yan/alti/hardware/docs/stm32l1_pins.xlsx

Sheet: Pins
UFQFPN48 | Name | Type | Structure | Function | AltFunc | AddtlFunc |  | Alti Assignment | Target
1 | VLCD(3) | S | VLCD | - | - |  |  | ?????????
2 | PC13-WKUP2 | I/O | FT | PC13 | - | RTC_TAMP1/RTC_TS/RTC_OUT/WKUP2
3 | PC14-OSC32_IN(4) | I/O | TC | PC14 | - | OSC32_IN |  | HSE | 16MHz xtal
4 | PC15-OSC32_OUT(4) | I/O | TC | PC15 | - | OSC32_OUT |  | HSE | 16MHz xtal
5 | PH0-OSC_IN(5) | I/O | TC | PH0 | - | OSC_IN |  | LSE | 32k xtal
6 | PH1-OSC_OUT | I/O | TC | PH1 | - | OSC_OUT |  | LSE | 32k xtal
7 | NRST | I/O | RST | NRST | - | - |  | RESET | Switch | CDC
8 | VSSA | S | - | VSSA | - | - |  | GND
9 | VDDA | S | - | VDDA | - | - |  | +3V
10 | PA0-WKUP1 | I/O | FT | PA0 | USART2_CTS/TIM2_CH1_ETR | WKUP1/ADC_IN0/COMP1_INP |  |  |  | AT45DB321E_RESET
11 | PA1 | I/O | FT | PA1 | USART2_RTS/TIM2_CH2/LCD_SEG0 | ADC_IN1/COMP1_INP |  |  |  | AT45DB321E_enable
12 | PA2 | I/O | FT | PA2 | USART2_TX/TIM2_CH3/TIM9_CH1/LCD_SEG1 | ADC_IN2/COMP1_INP |  |  | nrf8001_RSET
13 | PA3 | I/O | TC | PA3 | USART2_RX/TIM2_CH4/TIM9_CH2/LCD_SEG2 | ADC_IN3/COMP1_INP |  |  | nrf8001_RDYN
14 | PA4 | I/O | TC | PA4 | SPI1_NSS/USART2_CK | ADC_IN4/DAC_OUT1/COMP1_INP |  |  | nrf8001_REQN
15 | PA5 | I/O | TC | PA5 | SPI1_SCK/TIM2_CH1_ETR | ADC_IN5/DAC_OUT2/COMP1_INP |  | SPI1_SCK | nrf8001_SCK | AT45DB321E_SCK
16 | PA6 | I/O | FT | PA6 | SPI1_MISO/TIM3_CH1/LCD_SEG3/TIM10_CH1 | ADC_IN6/COMP1_INP |  | SPI1_MISO | nrf8001_MISO | AT45DB321E_MISO
17 | PA7 | I/O | FT | PA7 | SPI1_MOSI//TIM3_CH2/LCD_SEG4/TIM11_CH1 | ADC_IN7/COMP1_INP |  | SPI1_MOSI | nrf8001_MOSI | AT45DB321E_MOSI
18 | PB0 | I/O | TC | PB0 | TIM3_CH3/LCD_SEG5 | ADC_IN8/COMP1_INP/VREF_OUT
19 | PB1 | I/O | FT | PB1 | TIM3_CH4/LCD_SEG6 | ADC_IN9/COMP1_INP/VREF_OUT
20 | PB2 | I/O | FT | PB2/BOOT1 | BOOT1 | -
21 | PB10 | I/O | FT | PB10 | I2C2_SCL/USART3_TX/TIM2_CH3/LCD_SEG10 | - |  | NRF8001_Enable | nrf8001_enable
22 | PB11 | I/O | FT | PB11 | I2C2_SDA/USART3_RX/TIM2_CH4/LCD_SEG11 | - |  | ms5611_enable
23 | VSS_1 | S | - | VSS_1 | - | - |  | GND
24 | VDD_1 | S | - | VDD_1 | - | - |  | +3V
25 | PB12 | I/O | FT | PB12 | SPI2_NSS/I2C2_SMBA/USART3_CK/LCD_SEG12/TIM10_CH1 | ADC_IN18/COMP1_INP |  | ms5611_enable | ms5611_enable
26 | PB13 | I/O | FT | PB13 | SPI2_SCK/USART3_CTS/LCD_SEG13/TIM9_CH1 | ADC_IN19/COMP1_INP |  | SPI2_SCK | BMX055 SCK | MS5611_SCK
27 | PB14 | I/O | FT | PB14 | SPI2_MISO/USART3_RTS/LCD_SEG14//TIM9_CH2 | ADC_IN20/COMP1_INP |  | SPI2_MISO | BMX055 MISO | MS5611_MISO
28 | PB15 | I/O | FT | PB15 | SPI2_MOSI/LCD_SEG15/TIM11_CH1 | ADC_IN21/COMP1_INP/RTC_REFIN |  | SPI2_MOSI | BMX055 MOSI | MS5611_MOSI
29 | PA8 | I/O | FT | PA8 | USART1_CK/MCO/LCD_COM0 | - |  |  | BMX055 M EN
30 | PA9 | I/O | FT | PA9 | USART1_TX/LCD_COM1 | - |  |  | BMX055 A EN
31 | PA10 | I/O | FT | PA10 | USART1_RX/LCD_COM2 | - |  |  | BMX055 G EN
32 | PA11 | I/O | FT | PA11 | USART1_CTS | USB_DM |  | USB_DM | USB_HEADER
33 | PA12 | I/O | FT | PA12 | USART1_RTS/SPI1_MOSI | USB_DP |  | USB_DP | USB_HEADER
34 | PA13 | I/O | FT | JTMSSWDIO | JTMS-SWDIO | - |  | SWD |  | CDC
35 | VSS_2 | S | - | VSS_2 | - | - |  | GND
36 | VDD_2 | S | - | VDD_2 | - | - |  | +3V
37 | PA14 | I/O | FT | JTCK | -SWCLK | JTCK-SWCLK |  | SWCLK |  | CDC
38 | PA15 | I/O | FT | JTDI | TIM2_CH1_ETR/PA15/SPI1_NSS/LCD_SEG17 | - |  |  |  | CDC
39 | PB3 | I/O | FT | JTDO | TIM2_CH2/PB3/SPI1_SCK/LCD_SEG7/JTDO | COMP2_INM |  |  |  | CDC
40 | PB4 | I/O | FT | NJTRST | TIM3_CH1/PB4/SPI1_MISO/LCD_SEG8/NJTRST | COMP2_INP |  | STATUS LED
41 | PB5 | I/O | FT | PB5 | I2C1_SMBA/TIM3_CH2/SPI1_MOSI/LCD_SEG9 | COMP2_INP
42 | PB6 | I/O | FT | PB6 | I2C1_SCL/TIM4_CH1/USART1_TX
43 | PB7 | I/O | FT | PB7 | I2C1_SDA/TIM4_CH2/USART1_RX | PVD_IN
44 | BOOT0 | I | B | BOOT0 | - | - |  | BOOT0 (tie to gnd or vcc)
45 | PB8 | I/O | FT | PB8 | TIM4_CH3/I2C1_SCL/LCD_SEG16/TIM10_CH1 | - |  | WARN LED select
46 | PB9 | I/O | FT | PB9 | TIM4_CH4/I2C1_SDA/LCD_COM3/TIM11_CH1 | - |  | WARN LED enable
47 | VSS_3 | S | - | VSS_3 | - | - |  | GND
48 | VDD_3 | S | - | VDD_3 | - | - |  | +3V
- | PE2 | I/O | FT | PE2 | TRACECLK/LCD_SEG38/TIM3_ETR | -
- | PE3 | I/O | FT | PE3 | TRACED0/LCD_SEG39/TIM3_CH1 | -
- | PE4 | I/O | FT | PE4 | TRACED1/TIM3_CH2 | -
- | PE5 | I/O | FT | PE5 | TRACED2/TIM9_CH1 | -
- | PE6-WKUP3 | I/O | FT | PE6 | TRACED3/TIM9_CH2 | WKUP3
- | VSS_5 | S | - | VSS_5 | - | -
- | VDD_5 | S | - | VDD_5 | - | -
- | PC0 | I/O | FT | PC0 | LCD_SEG18 | ADC_IN10//COMP1_INP
- | PC1 | I/O | FT | PC1 | LCD_SEG19 | ADC_IN11/COMP1_INP
- | PC2 | I/O | FT | PC2 | LCD_SEG20 | ADC_IN12/COMP1_INP
- | PC3 | I/O | TC | PC3 | LCD_SEG21 | ADC_IN13/COMP1_INP
- | VREF- | S | - | VREF- | - | -
- | VREF+ | S | - | VREF+ | - | -
- | VSS_4 | S | - | VSS_4 | - | -
- | VDD_4 | S | - | VDD_4 | - | -
- | PC4 | I/O | FT | PC4 | LCD_SEG22 | ADC_IN14/COMP1_INP
- | PC5 | I/O | FT | PC5 | LCD_SEG23 | ADC_IN15/COMP1_INP
- | PE7 | I/O | TC | PE7 | - | ADC_IN22/COMP1_INP
- | PE8 | I/O | TC | PE8 | - | ADC_IN23/COMP1_INP
- | PE9 | I/O | TC | PE9 | TIM2_CH1_ETR | ADC_IN24/COMP1_INP
- | PE10 | I/O | TC | PE10 | TIM2_CH2 | ADC_IN25/COMP1_INP
- | PE11 | I/O | FT | PE11 | TIM2_CH3 | -
- | PE12 | I/O | FT | PE12 | TIM2_CH4/SPI1_NSS | -
- | PE13 | I/O | FT | PE13 | SPI1_SCK | -
- | PE14 | I/O | FT | PE14 | SPI1_MISO | -
- | PE15 | I/O | FT | PE15 | SPI1_MOSI | -
- | PD8 | I/O | FT | PD8 | USART3_TX/LCD_SEG28 | -
- | PD9 | I/O | FT | PD9 | USART3_RX/LCD_SEG29 | - | -
- | PD10 | I/O | FT | PD10 | USART3_CK/LCD_SEG30 | -
- | PD11 | I/O | FT | PD11 | USART3_CTS/LCD_SEG31 | -
- | PD12 | I/O | FT | PD12 | TIM4_CH1/USART3_RTS/LCD_SEG32 | -
- | PD13 | I/O | FT | PD13 | TIM4_CH2/LCD_SEG33 | -
- | PD14 | I/O | FT | PD14 | TIM4_CH3/LCD_SEG34 | -
- | PD15 | I/O | FT | PD15 | TIM4_CH4/LCD_SEG35 | -
- | PC6 | I/O | FT | PC6 | TIM3_CH1/LCD_SEG24 | -
- | PC7 | I/O | FT | PC7 | TIM3_CH2/LCD_SEG25 | -
- | PC8 | I/O | FT | PC8 | TIM3_CH3/LCD_SEG26 | -
- | PC9 | I/O | FT | PC9 | TIM3_CH4/LCD_SEG27 | -
- | PH2 | I/O | FT | PH2 | - | -
- | PC10 | I/O | FT | PC10 | USART3_TX/LCD_SEG28/LCD_SEG40/LCD_COM4 | -
- | PC11 | I/O | FT | PC11 | USART3_RX/LCD_SEG29/LCD_SEG41/LCD_COM5 | -
- | PC12 | I/O | FT | PC12 | USART3_CK/LCD_SEG30/LCD_SEG42/LCD_COM6 | -
- | PD0 | I/O | FT | PD0 | SPI2_NSS/TIM9_CH1 | -
- | PD1 | I/O | FT | PD1 | SPI2_SCK | -
- | PD2 | I/O | FT | PD2 | TIM3_ETR/LCD_SEG31/LCD_SEG43/LCD_COM7 | -
- | PD3 | I/O | FT | PD3 | USART2_CTS/SPI2_MISO | -
- | PD4 | I/O | FT | PD4 | USART2_RTS/SPI2_MOSI | -
- | PD5 | I/O | FT | PD5 | USART2_TX | -
- | PD6 | I/O | FT | PD6 | USART2_RX | -
- | PD7 | I/O | FT | PD7 | USART2_CK/TIM9_CH2 | -
- | PE0 | I/O | FT | PE0 | TIM4_ETR/LCD_SEG36/TIM10_CH1 | -
- | PE1 | I/O | FT | PE1 | LCD_SEG37/TIM11_CH1 | -
 |  |  |  |  |  |  |  |  | BMX055 A Interrupt
 |  |  |  |  |  |  |  |  | Piezo Enable
 |  |  |  |  |  |  |  |  | Piezo Out

Sheet: BOM
Mfgr Part # | Description | Price
