yan/alti/hardware/pcb/aero.kicad_pcb

## KiCad design hardware/pcb/aero.kicad_pcb (2015-10-28)

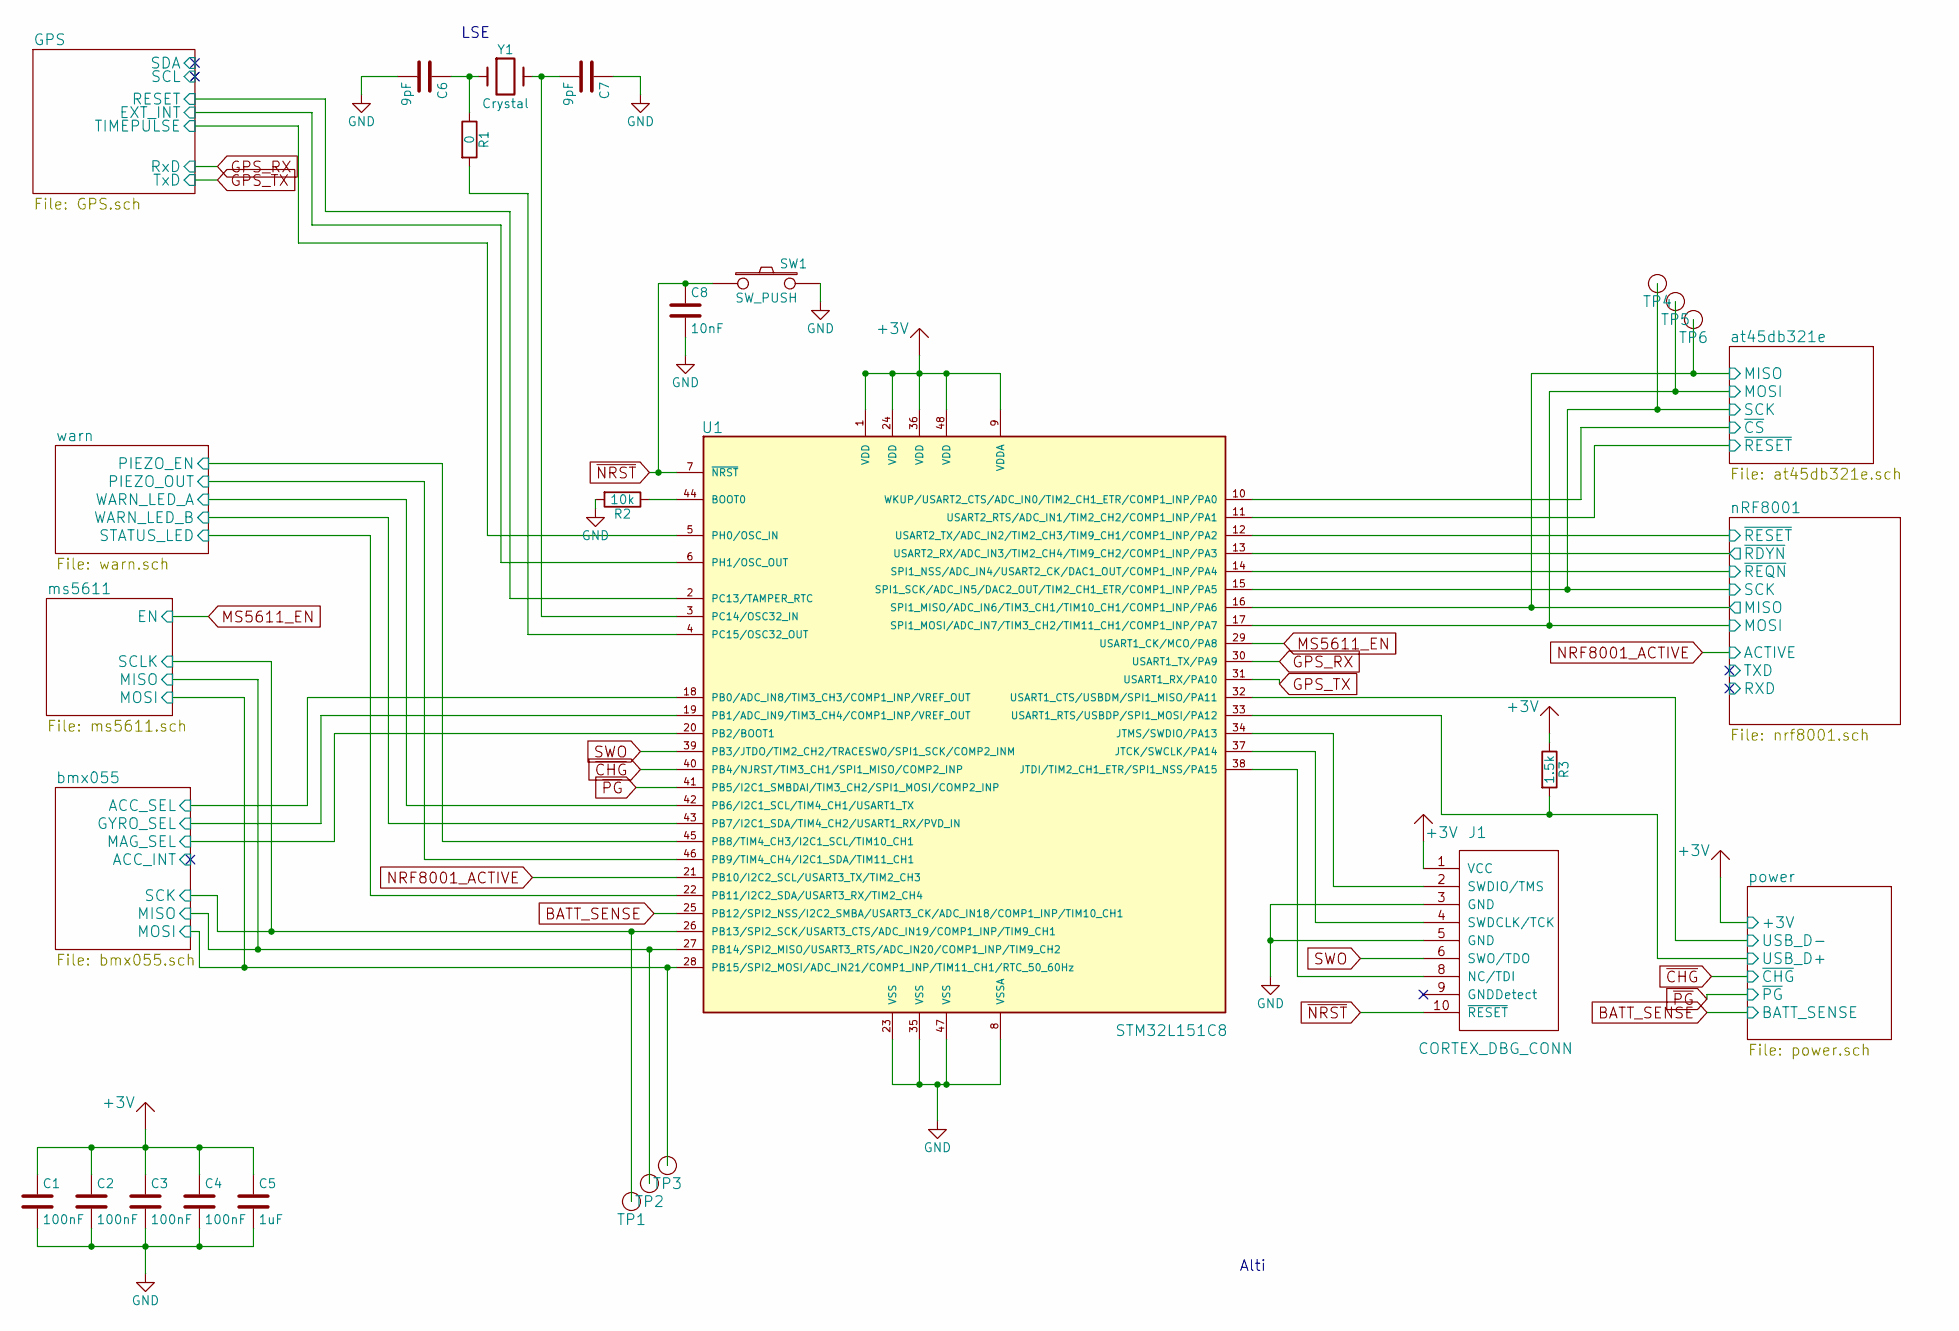
[picture p1: schematic aero.sch]

Parts:
C1, C2, C3, C4: 100nF; C_0402
C5: 1uF; C_0402
C6, C7: 9pF; C_0402
C8: 10nF; C_0402
J1: CORTEX_DBG_CONN; TC2050-IDC-NL
R1: 0; R_0402
R2: 10k; R_0402
R3: 1.5k; R_0402
SW1: SW_PUSH; B3U-1000P
TP1, TP2, TP3, TP4, TP5, TP6: Test_Point; TP_0603
U1: STM32L151C8; UFQFPN48
Y1: Crystal; Crystal_32768_FC-135R

Connections:
+3V: C1.1, C2.1, C3.1, C4.1, C5.1, J1.1 (VCC), R3.1, U1.1 (VDD), U1.9 (VDDA), U1.24 (VDD), U1.36 (VDD), U1.48 (VDD); also elsewhere on the board
/GPS/EXT_INT: U1.6 (PH1/OSC_OUT); also elsewhere on the board
/GPS/RESET: U1.2 (PC13/TAMPER_RTC); also elsewhere on the board
/GPS/TIMEPULSE: U1.5 (PH0/OSC_IN); also elsewhere on the board
/at45db321e/MISO: TP6.1, U1.16 (SPI1_MISO/ADC_IN6/TIM3_CH1/TIM10_CH1/CO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); also elsewhere on the board
/at45db321e/MOSI: TP5.1, U1.17 (SPI1_MOSI/ADC_IN7/TIM3_CH2/TIM11_CH1/CO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); also elsewhere on the board
/at45db321e/SCK: TP4.1, U1.15 (SPI1_SCK/ADC_IN5/DAC2_OUT/TIM2_CH1_ETR/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); also elsewhere on the board
/at45db321e/~CS: U1.10 (WKUP/USART2_CTS/ADC_IN0/TIM2_CH1_ETR/CO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); also elsewhere on the board
/at45db321e/~RESET: U1.11 (USART2_RTS/ADC_IN1/TIM2_CH2/COMP1_INP/P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); also elsewhere on the board
/bmx055/ACC_SEL: U1.18 (PB0/ADC_IN8/TIM3_CH3/COMP1_INP/VREF_OUT); also elsewhere on the board
/bmx055/GYRO_SEL: U1.19 (PB1/ADC_IN9/TIM3_CH4/COMP1_INP/VREF_OUT); also elsewhere on the board
/bmx055/MAG_SEL: U1.20 (PB2/BOOT1); also elsewhere on the board
/bmx055/MISO: TP2.1, U1.27 (PB14/SPI2_MISO/USART3_RTS/ADC_IN20/COMP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); also elsewhere on the board
/bmx055/MOSI: TP3.1, U1.28 (PB15/SPI2_MOSI/ADC_IN21/COMP1_INP/TIM11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); also elsewhere on the board
/bmx055/SCK: TP1.1, U1.26 (PB13/SPI2_SCK/USART3_CTS/ADC_IN19/COMP1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); also elsewhere on the board
/nRF8001/~RDYN: U1.13 (USART2_RX/ADC_IN3/TIM2_CH4/TIM9_CH2/COM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); also elsewhere on the board
/nRF8001/~REQN: U1.14 (SPI1_NSS/ADC_IN4/USART2_CK/DAC1_OUT/COM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); also elsewhere on the board
/nRF8001/~RESET: U1.12 (USART2_TX/ADC_IN2/TIM2_CH3/TIM9_CH1/COM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); also elsewhere on the board
/power/USB_D+: R3.2, U1.33 (USART1_RTS/USBDP/SPI1_MOSI/PA12); also elsewhere on the board
/power/USB_D-: U1.32 (USART1_CTS/USBDM/SPI1_MISO/PA11); also elsewhere on the board
/warn/PIEZO_EN: U1.45 (PB8/TIM4_CH3/I2C1_SCL/TIM10_CH1); also elsewhere on the board
/warn/PIEZO_OUT: U1.46 (PB9/TIM4_CH4/I2C1_SDA/TIM11_CH1); also elsewhere on the board
/warn/STATUS_LED: U1.22 (PB11/I2C2_SDA/USART3_RX/TIM2_CH4); also elsewhere on the board
/warn/WARN_LED_A: U1.42 (PB6/I2C1_SCL/TIM4_CH1/USART1_TX); also elsewhere on the board
/warn/WARN_LED_B: U1.43 (PB7/I2C1_SDA/TIM4_CH2/USART1_RX/PVD_IN); also elsewhere on the board
BATT_SENSE: U1.25 (PB12/SPI2_NSS/I2C2_SMBA/USART3_CK/ADC_I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); also elsewhere on the board
GND: C1.2, C2.2, C3.2, C4.2, C5.2, C6.2, C7.1, C8.2, J1.3 (GND), J1.5 (GND), R2.2, SW1.2, U1.8 (VSSA), U1.23 (VSS), U1.35 (VSS), U1.47 (VSS), U1.49; also elsewhere on the board
GPS_RX: U1.30 (USART1_TX/PA9); also elsewhere on the board
GPS_TX: U1.31 (USART1_RX/PA10); also elsewhere on the board
MS5611_EN: U1.29 (USART1_CK/MCO/PA8); also elsewhere on the board
NRF8001_ACTIVE: U1.21 (PB10/I2C2_SCL/USART3_TX/TIM2_CH3); also elsewhere on the board
unnamed: C6.1, R1.1, Y1.1
unnamed: C7.2, U1.3 (PC14/OSC32_IN), Y1.2
unnamed: J1.2 (SWDIO/TMS), U1.34 (JTMS/SWDIO/PA13)
unnamed: J1.4 (SWDCLK/TCK), U1.37 (JTCK/SWCLK/PA14)
unnamed: J1.8 (NC/TDI), U1.38 (JTDI/TIM2_CH1_ETR/SPI1_NSS/PA15)
unnamed: R1.2, U1.4 (PC15/OSC32_OUT)
unnamed: R2.1, U1.44 (BOOT0)
SWO: J1.6 (SWO/TDO), U1.39 (PB3/JTDO/TIM2_CH2/TRACESWO/SPI1_SCK/COM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)
~CHG: U1.40 (PB4/NJRST/TIM3_CH1/SPI1_MISO/COMP2_INP); also elsewhere on the board
~NRST: C8.1, J1.10 (~RESET), SW1.1, U1.7 (~NRST)
~PG: U1.41 (PB5/I2C1_SMBDAI/TIM3_CH2/SPI1_MOSI/COMP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); also elsewhere on the board

Notes on the sheet:
LSE
Alti

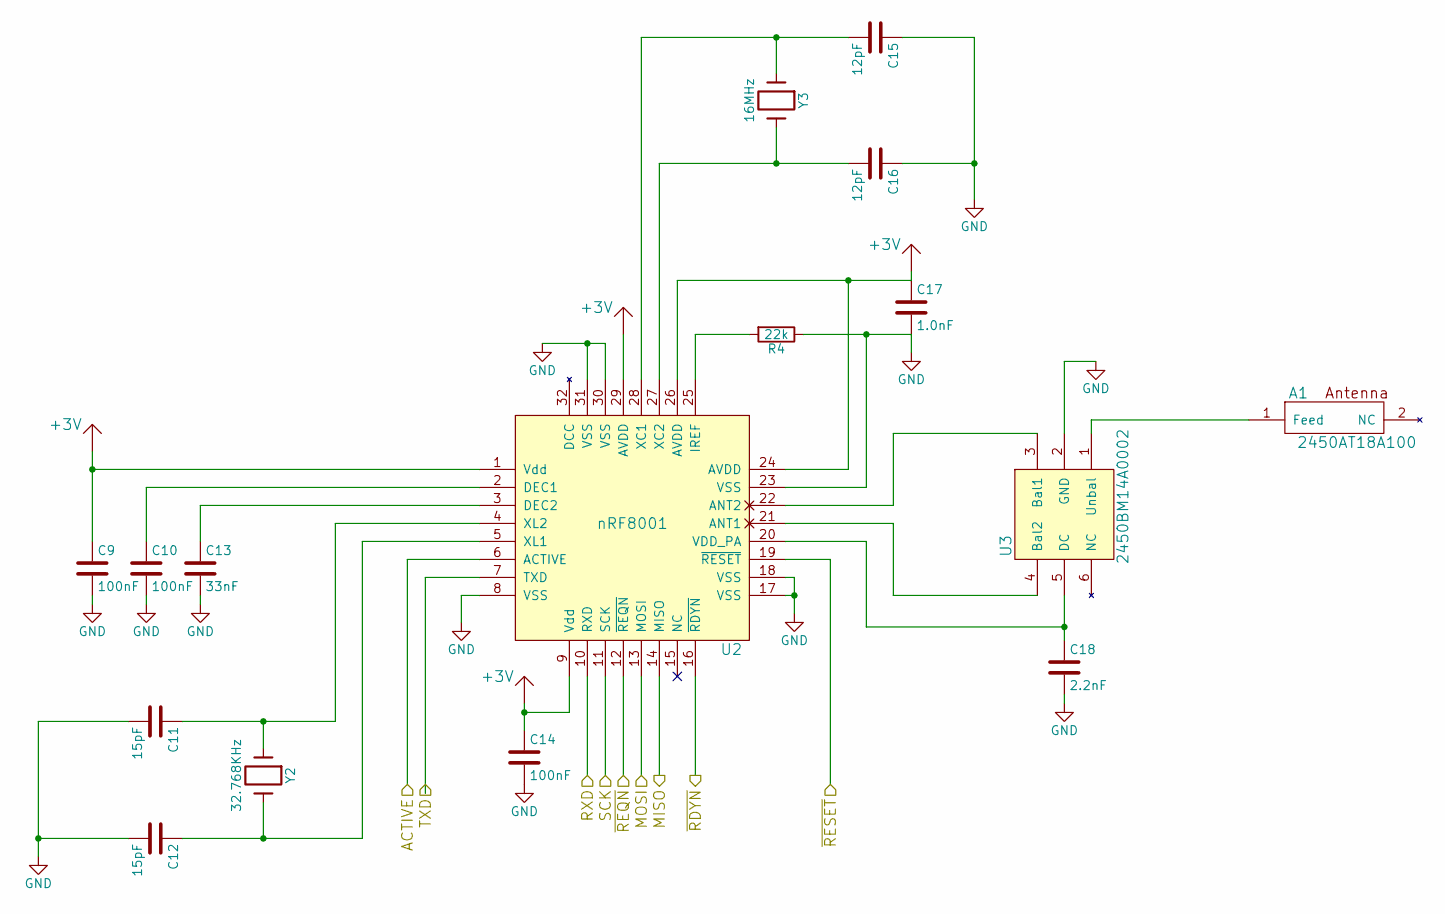
[picture p2: schematic nrf8001.sch]

Parts:
A1: 2450AT18A100
C9, C10, C14: 100nF; C_0402
C11, C12: 15pF; C_0402
C13: 33nF; C_0402
C15, C16: 12pF; C_0402
C17: 1.0nF; C_0402
C18: 2.2nF; C_0402
R4: 22k; R_0402
U2: nRF8001; QFN-32-1EP_5x5mm_Pitch0.5mm
U3: 2450BM14A0002
Y2: 32.768KHz; Crystal_32768_FC-135R
Y3: 16MHz; Crystal_TSX_3225

Connections:
+3V: C9.1, C14.1, C17.1, U2.1 (Vdd), U2.9 (Vdd), U2.24 (AVDD), U2.26 (AVDD), U2.29 (AVDD); also elsewhere on the board
/at45db321e/MISO: U2.14 (MISO); also elsewhere on the board
/at45db321e/MOSI: U2.13 (MOSI); also elsewhere on the board
/at45db321e/SCK: U2.11 (SCK); also elsewhere on the board
/nRF8001/~RDYN: U2.16 (~RDYN); also elsewhere on the board
/nRF8001/~REQN: U2.12 (~REQN); also elsewhere on the board
/nRF8001/~RESET: U2.19 (~RESET); also elsewhere on the board
GND: C9.2, C10.2, C11.2, C12.2, C13.2, C14.2, C15.1, C16.1, C17.2, C18.2, R4.1, U2.8 (VSS), U2.17 (VSS), U2.18 (VSS), U2.23 (VSS), U2.30 (VSS), U2.31 (VSS), U2.33, U3.2 (GND); also elsewhere on the board
NRF8001_ACTIVE: U2.6 (ACTIVE); also elsewhere on the board
unnamed: A1.1 (Feed), U3.1 (Unbal)
unnamed: C10.1, U2.2 (DEC1)
unnamed: C11.1, U2.4 (XL2), Y2.1
unnamed: C12.1, U2.5 (XL1), Y2.2
unnamed: C13.1, U2.3 (DEC2)
unnamed: C15.2, U2.28 (XC1), Y3.1
unnamed: C16.2, U2.27 (XC2), Y3.2
unnamed: C18.1, U2.20 (VDD_PA), U3.5 (DC)
unnamed: R4.2, U2.25 (IREF)
unnamed: U2.21 (ANT1), U3.4 (Bal2)
unnamed: U2.22 (ANT2), U3.3 (Bal1)

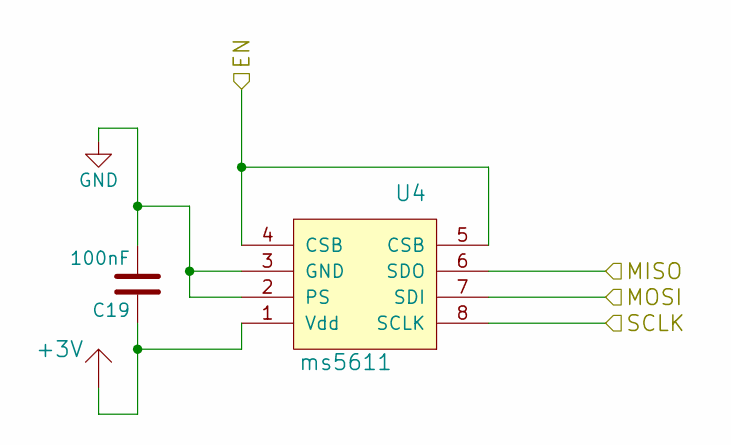
[picture p3: schematic ms5611.sch]

Parts:
C19: 100nF; C_0402
U4: ms5611

Connections:
+3V: C19.1, U4.1 (Vdd); also elsewhere on the board
/bmx055/MISO: U4.6 (SDO); also elsewhere on the board
/bmx055/MOSI: U4.7 (SDI); also elsewhere on the board
/bmx055/SCK: U4.8 (SCLK); also elsewhere on the board
GND: C19.2, U4.2 (PS), U4.3 (GND); also elsewhere on the board
MS5611_EN: U4.4 (CSB), U4.5 (CSB); also elsewhere on the board

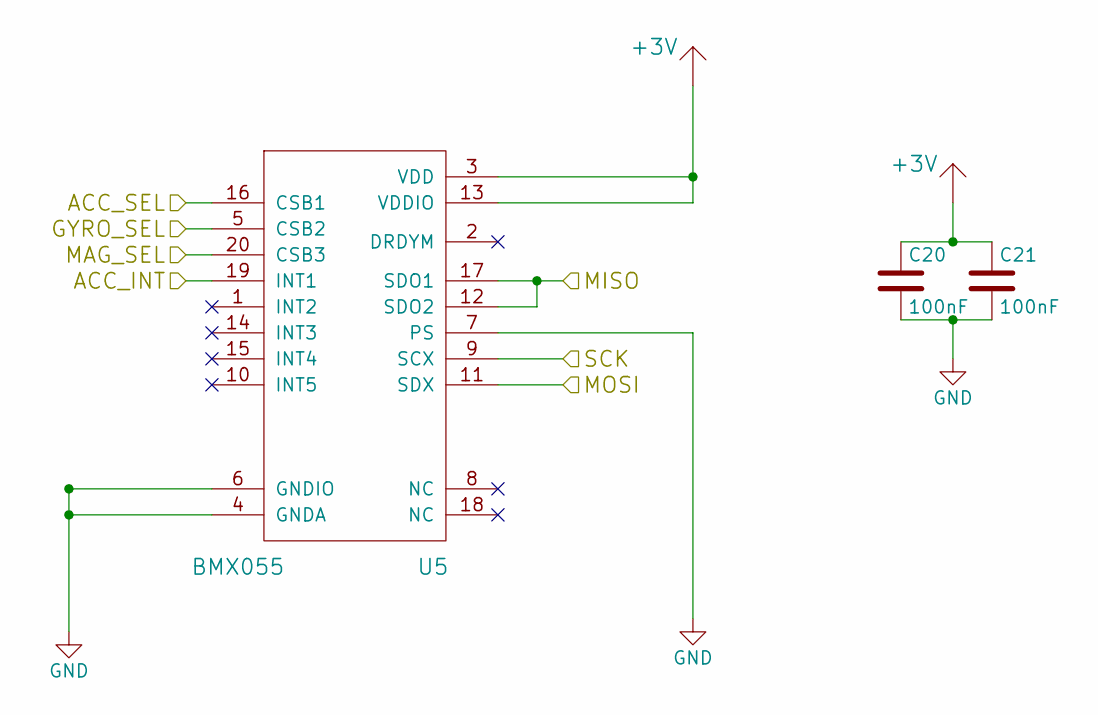
[picture p4: schematic bmx055.sch]

Parts:
C20, C21: 100nF; C_0402
U5: BMX055

Connections:
+3V: C20.1, C21.1, U5.3 (VDD), U5.13 (VDDIO); also elsewhere on the board
/bmx055/ACC_SEL: U5.16 (CSB1); also elsewhere on the board
/bmx055/GYRO_SEL: U5.5 (CSB2); also elsewhere on the board
/bmx055/MAG_SEL: U5.20 (CSB3); also elsewhere on the board
/bmx055/MISO: U5.12 (SDO2), U5.17 (SDO1); also elsewhere on the board
/bmx055/MOSI: U5.11 (SDX); also elsewhere on the board
/bmx055/SCK: U5.9 (SCX); also elsewhere on the board
GND: C20.2, C21.2, U5.4 (GNDA), U5.6 (GNDIO), U5.7 (PS); also elsewhere on the board

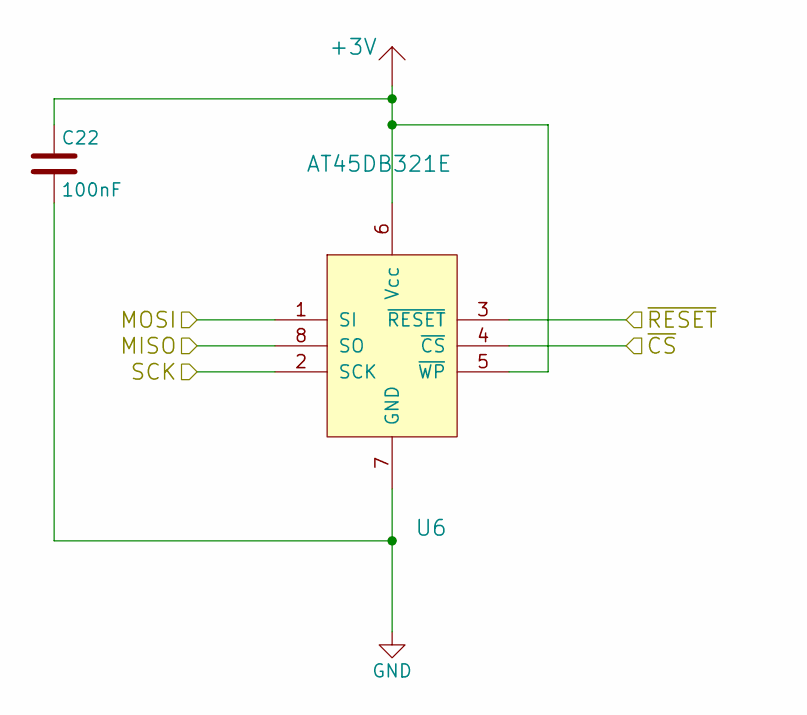
[picture p5: schematic at45db321e.sch]

Parts:
C22: 100nF; C_0402
U6: AT45DB321E; UDFN-8

Connections:
+3V: C22.1, U6.5 (~WP), U6.6 (Vcc); also elsewhere on the board
/at45db321e/MISO: U6.8 (SO); also elsewhere on the board
/at45db321e/MOSI: U6.1 (SI); also elsewhere on the board
/at45db321e/SCK: U6.2 (SCK); also elsewhere on the board
/at45db321e/~CS: U6.4 (~CS); also elsewhere on the board
/at45db321e/~RESET: U6.3 (~RESET); also elsewhere on the board
GND: C22.2, U6.7 (GND); also elsewhere on the board

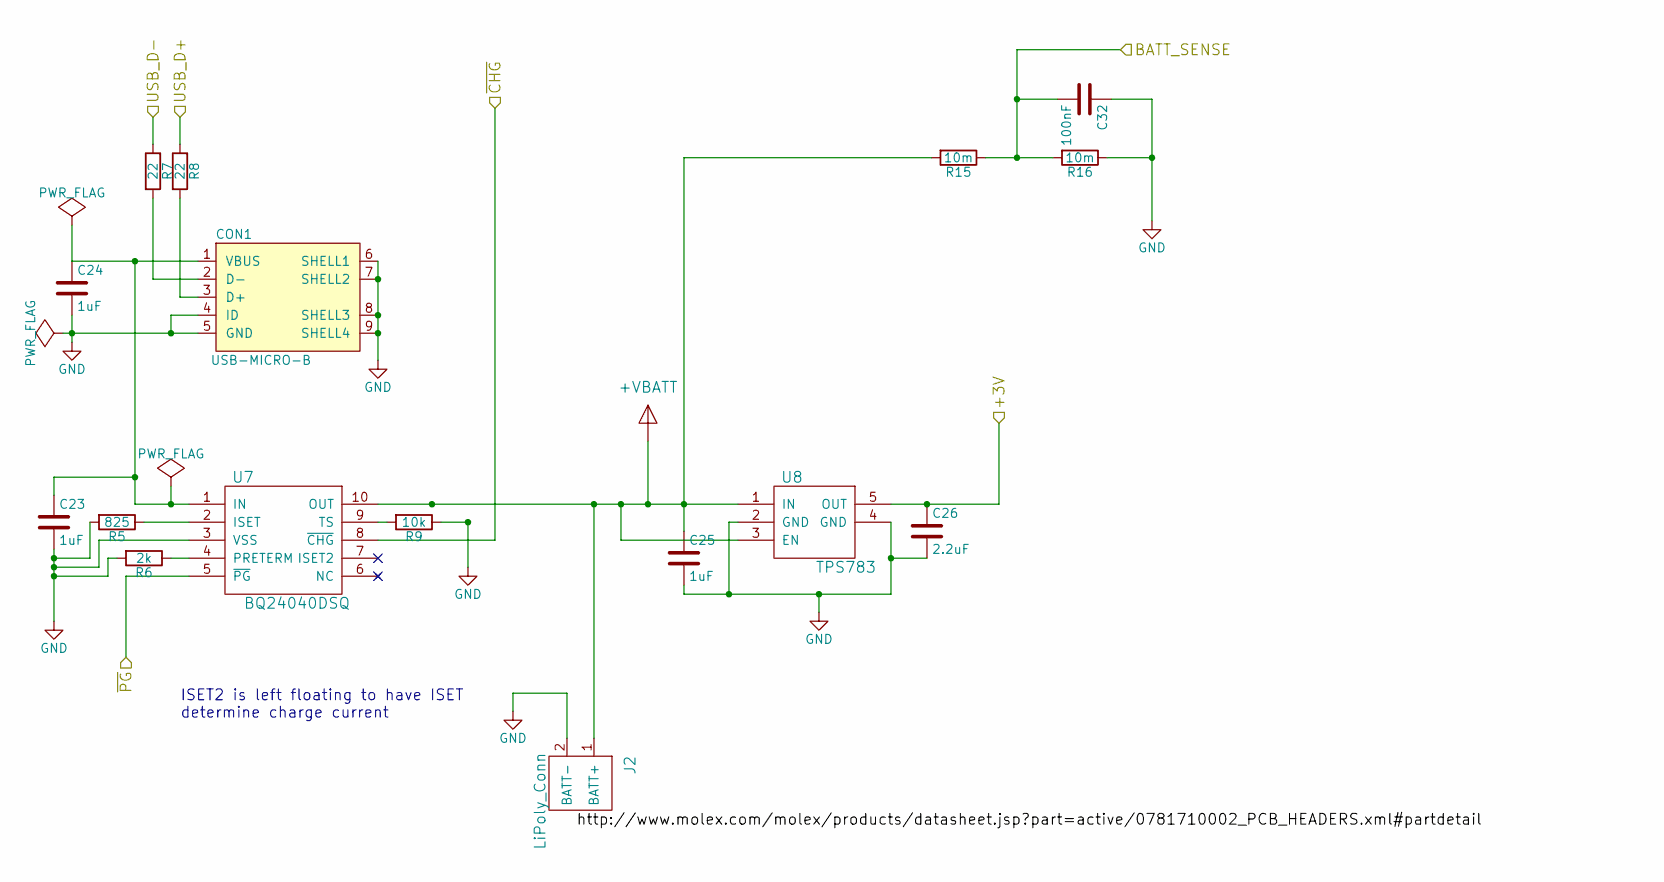
[picture p6: schematic power.sch]

Parts:
C23, C24, C25: 1uF; C_0402
C26: 2.2uF; C_0402
C32: 100nF; C_0402
CON1: USB-MICRO-B; WM1399CT-ND
J2: LiPoly_Conn; Pin_Header_Straight_1x02
R5: 825; R_0402
R6: 2k; R_0402
R7, R8: 22; R_0402
R9: 10k; R_0402
R15, R16: 10m; R_0402
U7: BQ24040DSQ; WSON-10-1EP
U8: TPS783; SOT-23-5

Connections:
+3V: C26.1, U8.5 (OUT); also elsewhere on the board
/power/USB_D+: R8.1; also elsewhere on the board
/power/USB_D-: R7.1; also elsewhere on the board
BATT_SENSE: C32.2, R15.1, R16.2; also elsewhere on the board
GND: C23.2, C24.2, C25.2, C26.2, C32.1, CON1.4 (ID), CON1.5 (GND), CON1.6 (SHELL1), CON1.7 (SHELL2), CON1.8 (SHELL3), CON1.9 (SHELL4), CON1.10, CON1.11, J2.2 (BATT-), R5.2, R6.2, R9.1, R16.1, U7.3 (VSS), U7.11, U8.2 (GND), U8.4 (GND); also elsewhere on the board
unnamed: C23.1, C24.1, CON1.1 (VBUS), U7.1 (IN)
unnamed: CON1.2 (D-), R7.2
unnamed: CON1.3 (D+), R8.2
unnamed: R5.1, U7.2 (ISET)
unnamed: R6.1, U7.4 (PRETERM)
unnamed: R9.2, U7.9 (TS)
Vbatt: C25.1, J2.1 (BATT+), R15.2, U7.10 (OUT), U8.1 (IN), U8.3 (EN); also elsewhere on the board
~CHG: U7.8 (~CHG); also elsewhere on the board
~PG: U7.5 (~PG); also elsewhere on the board

Notes on the sheet:
ISET2 is left floating to have ISET determine charge current

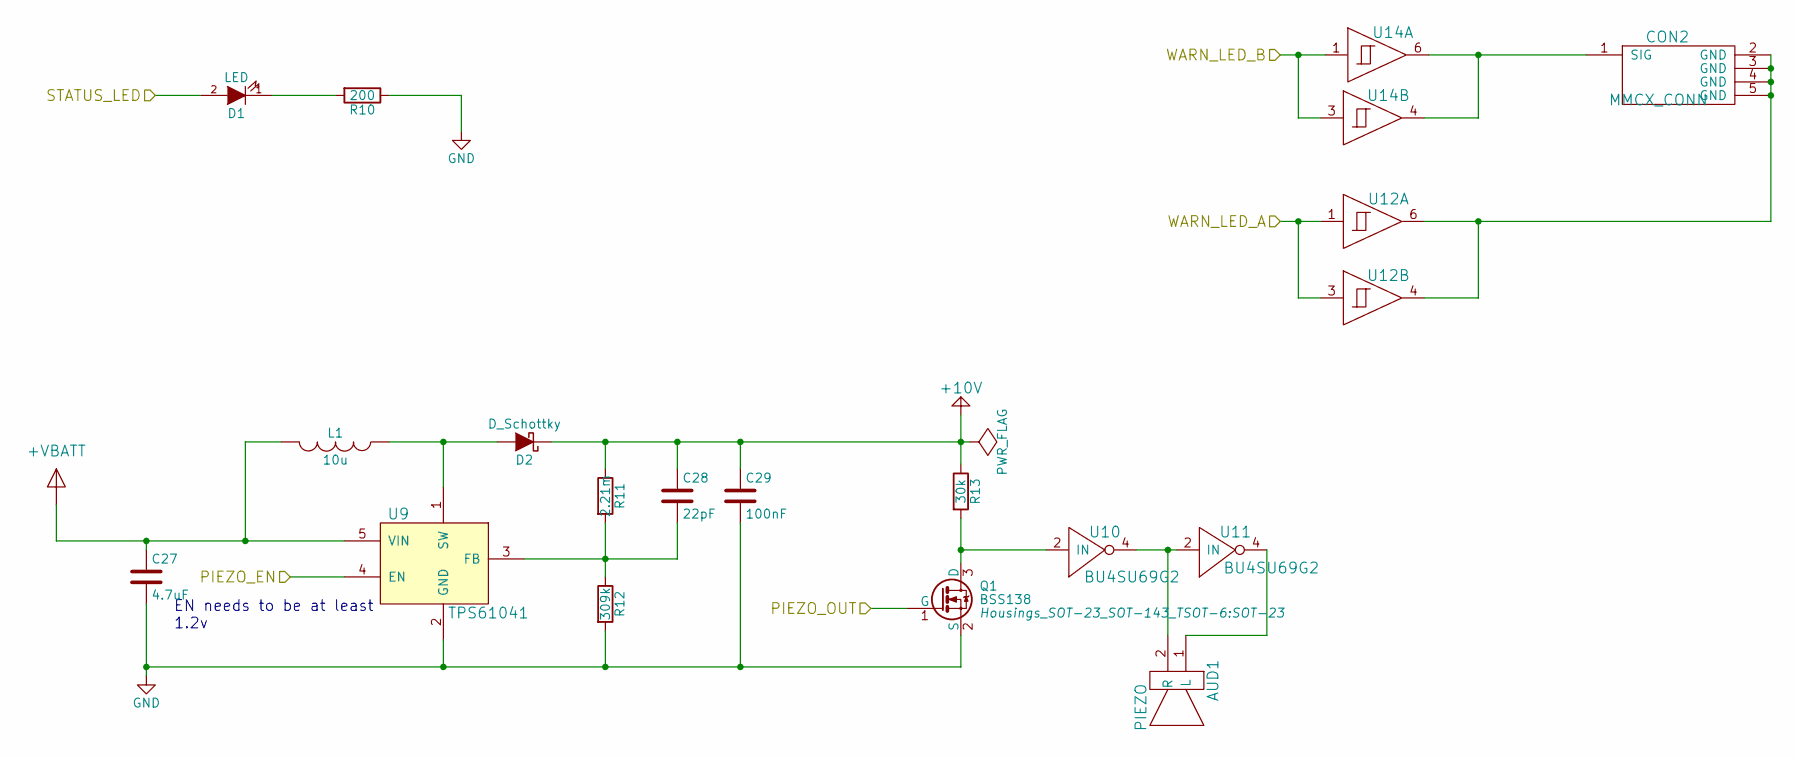
[picture p7: schematic warn.sch]

Parts:
AUD1: PIEZO; Piezo_Solder_Conn
C27: 4.7uF; C_0402
C28: 22pF; C_0402
C29: 100nF; C_0402
CON2: MMCX_CONN; CONMMCX002-SMD
D1: LED; LED-0805
D2: D_Schottky; SOD-123
L1: 10u; IND-744029100; Part# LQH3C100K24
Q1: BSS138; SOT-23
R10: 200; R_0402
R11: 2.21m; R_0402
R12: 309k; R_0402
R13: 30k; R_0402
U9: TPS61041; SOT-23-5
U10, U11: BU4SU69G2; SSOP-5
U12, U14: NC7WZ17; SC-70-6

Connections:
+3V: U12.5 (+3V), U14.5 (+3V); also elsewhere on the board
+10V: C28.1, C29.1, D2.1 (K), R11.1, R13.1, U10.5 (+10V), U11.5 (+10V)
/warn/PIEZO_EN: U9.4 (EN); also elsewhere on the board
/warn/PIEZO_OUT: Q1.1 (G); also elsewhere on the board
/warn/STATUS_LED: D1.2 (A); also elsewhere on the board
/warn/WARN_LED_A: U12.1, U12.3; also elsewhere on the board
/warn/WARN_LED_B: U14.1, U14.3; also elsewhere on the board
GND: C27.2, C29.2, Q1.2 (S), R10.1, R12.2, U9.2 (GND), U10.3 (GND), U11.3 (GND), U12.2 (GND), U14.2 (GND); also elsewhere on the board
unnamed: AUD1.1 (L), U11.4
unnamed: AUD1.2 (R), U10.4, U11.2 (IN)
unnamed: C28.2, R11.2, R12.1, U9.3 (FB)
unnamed: CON2.1 (SIG), U14.4, U14.6
unnamed: CON2.2 (GND), CON2.3 (GND), CON2.4 (GND), CON2.5 (GND), U12.4, U12.6
unnamed: D1.1 (K), R10.2
unnamed: D2.2 (A), L1.1, U9.1 (SW)
unnamed: Q1.3 (D), R13.2, U10.2 (IN)
Vbatt: C27.1, L1.2, U9.5 (VIN); also elsewhere on the board

Notes on the sheet:
EN needs to be at least 1.2v

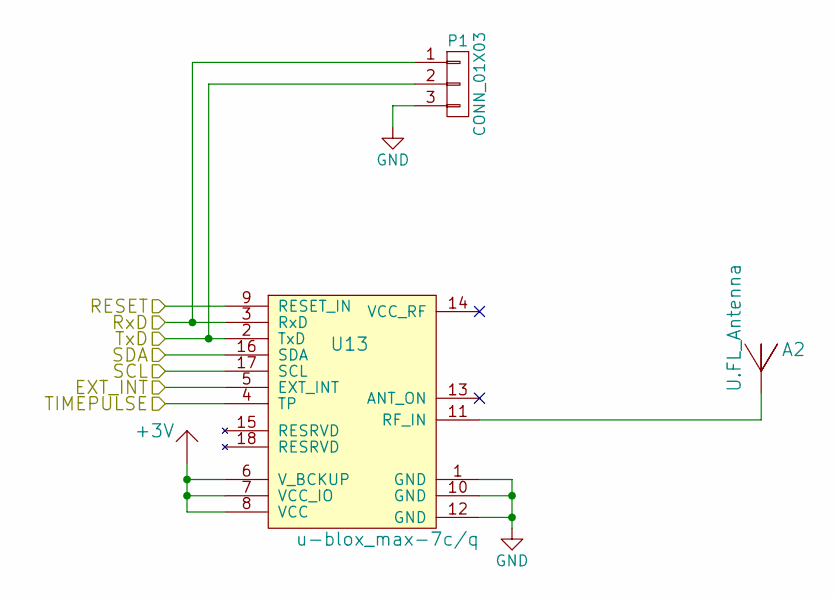
[picture p8: schematic GPS.sch]

Parts:
A2: U.FL_Antenna; CGGP.25.4.A.02
P1: CONN_01X03; Pin_Header_Straight_1x03
U13: u-blox_max-7c/q; ublox_MAX7

Connections:
+3V: U13.6 (V_BCKUP), U13.7 (VCC_IO), U13.8 (VCC); also elsewhere on the board
/GPS/EXT_INT: U13.5 (EXT_INT); also elsewhere on the board
/GPS/RESET: U13.9 (RESET_IN); also elsewhere on the board
/GPS/TIMEPULSE: U13.4 (TP); also elsewhere on the board
GND: P1.3, U13.1 (GND), U13.10 (GND), U13.12 (GND); also elsewhere on the board
GPS_RX: P1.1, U13.3 (RxD); also elsewhere on the board
GPS_TX: P1.2, U13.2 (TxD); also elsewhere on the board
unnamed: A2.1, U13.11 (RF_IN)

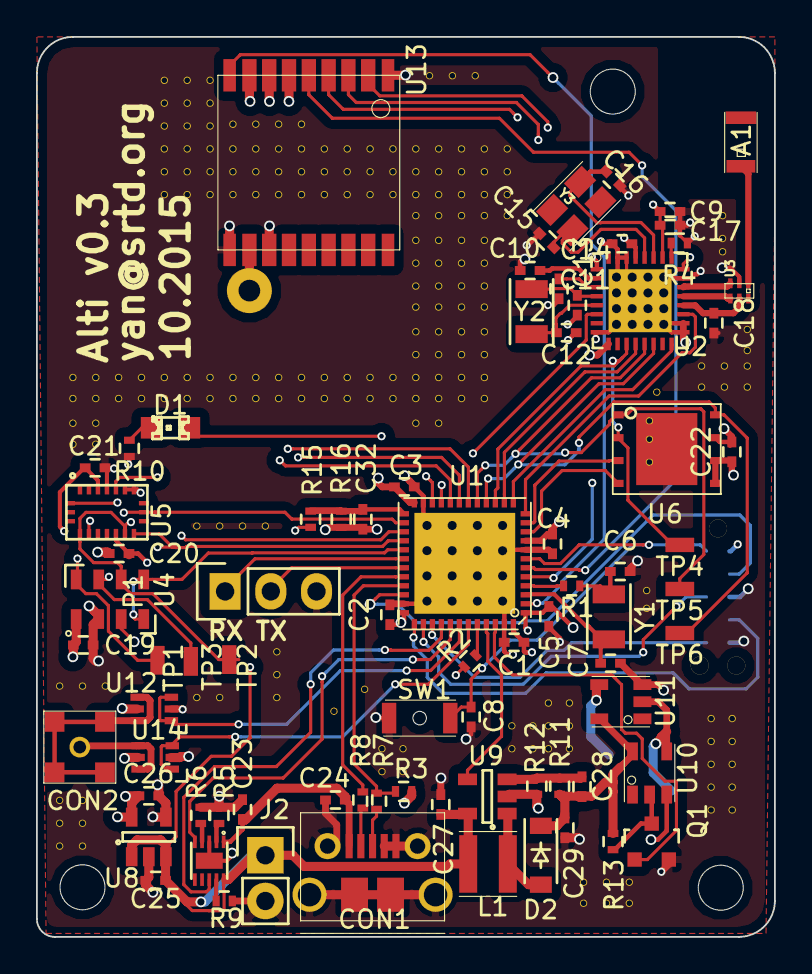
[picture p9: board aero.kicad_pcb from above]

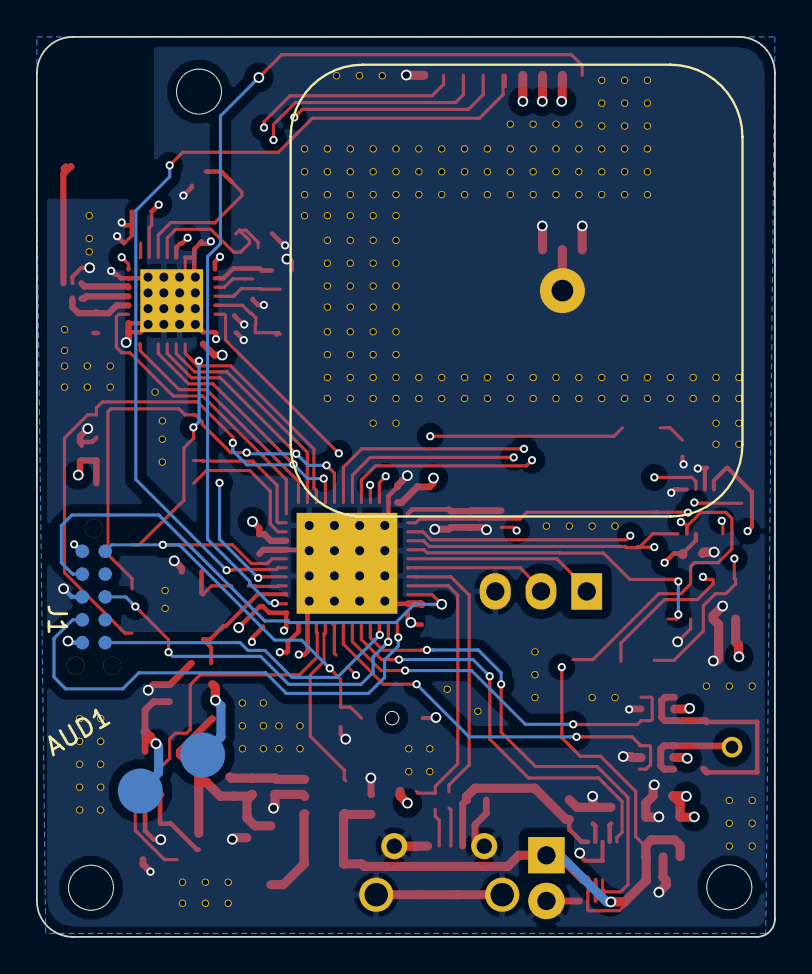
[picture p10: board aero.kicad_pcb from below]

Board: 4 copper layers, 41.0 x 50.0 mm, 81 parts (3 on the bottom side), 70 nets.
