yan/alti/firmware/include/task_main.h

/**
 * Copyright 2015 Yan Ivnitskiy
 */


#ifndef __TASK_MAIN_H
#define __TASK_MAIN_H

#ifdef __cplusplus
extern "C" {
#endif

/**
 * XXX
 */
void task_main(void *p);

#ifdef __cplusplus
}
#endif

#endif
