yan/alti/firmware/include/logger.h

/**
 * Copyright 2016 Yan Ivnitskiy
 */

#pragma once

#include <sample.h>

#ifdef __cplusplus
extern "C" {
#endif

struct event_private_s {
  /** @brief The start address of the samples. */
  uint32_t start_address;
  uint32_t current_address;
  // struct {
    uint16_t finished_logging : 1;
    uint16_t written : 1;
  // };
};
/**
 * @brief The header for an 'event'. Likely a jump.
 */
struct event_header_s {
  //uint32_t flag : 1;
  /** @brief The unique id of this event */
  uint16_t event_id;// : sizeof(uint32_t) * 8 - 1;
  /** @brief Size of each sample */
  uint16_t sample_size;
  /** @brief Number of samples associated with this event */
  uint32_t samples;
  /** @brief Bitmask representing what features were enabled during logging.
   * Set to CONFIG_FEATURES */
  uint8_t features;
  /** @brief Whether the event is in progress */
  uint8_t in_progress;
  /** @brief Milliseconds since Jan 1, 1970 to the start of this event */
  uint32_t rtc_start;
  /** @brief The address of the previously recorded field */
  uint32_t last_event;
} __attribute__((packed));

/** @brief Private fields  */
struct event_s {
  struct event_header_s header;
  struct event_private_s _private;
} __attribute__((packed));

#ifndef offsetof
#define offsetof(type, member) ( (size_t) & ((type*)0) -> member )
#endif

#define EVENT_HEADER_SIZE sizeof(struct event_header_s)
  
/** TODO: Check for overflow */
#define TOTAL_EVENT_SIZE(ev)  \
  (((ev).samples * (ev).sample_size) + EVENT_HEADER_SIZE)

/**
 * @brief Lazily reformat storage; overwrites header.
 */
void logger_format_storage(void);

/**
 * @brief Start a new event, initializing |event| in the process.
 * 
 * @param event An allocated event instance.
 */
void logger_start_event(struct event_s *event);

/**
 * @brief Commit |event| to storage.
 */
void logger_end_event(struct event_s *event);

/**
 * @brief Read the |n|th (0-indexed) sample fro |event| into the packet pointed
 * to by |dest|
 */
int  logger_read_sample(struct event_s *event, uint32_t n, struct sensor_packet_s *dest);

/**
 * @brief Add a sample to an in-progress event.
 *
 * @return 1 on success, 0 on failure.
 */
int logger_write_sample(struct event_s *event, struct sensor_packet_s *packet);

/**
 * @brief Get a stored event.
 */
int logger_get_event(struct event_s *prev, struct event_s *dst);


/* private declarations below this line ======== */

#ifdef __cplusplus
}
#endif
