yan/alti/firmware/include/bmx055.h

/**
 * Copyright 2015 Yan Ivnitskiy
 */
#ifndef __BMX055_H
#define __BMX055_H

#define BMX055_ACC_X_LSB_ADDR              0x02
#define BMX055_ACC_X_MSB_ADDR              0x03
#define BMX055_ACC_Y_LSB_ADDR              0x04
#define BMX055_ACC_Y_MSB_ADDR              0x05
#define BMX055_ACC_Z_LSB_ADDR              0x06
#define BMX055_ACC_Z_MSB_ADDR              0x07

int bmx055_reset(void);

enum direction_e {
  DIR_X,
  DIR_Y,
  DIR_Z
};

enum bmx055_device_e {
  BMX055_ACCEL,
  BMX055_GYRO,
  BMX055_MAG
};

int16_t bmx055_read(enum bmx055_device_e device, enum direction_e direction);

void bmx055_init(void);

#endif // __BMX055_H
