yan/alti/firmware/include/sample.h

#ifndef __SAMPLE_H
#define __SAMPLE_H

#include <ms5611.h>
//#include <config.h>
#include <features.h>

#if CONFIG_USE_GPS
struct gps_sample_s {
  int32_t accuracy;
  int32_t lat, lon;
  int32_t ground_speed;
  int32_t heading;
} __attribute__((packed));
#endif

#if CONFIG_USE_ACCEL
struct accel_sample_s { 
  int16_t accel[3];
} __attribute__((packed));
#endif

struct baro_sample_s {
  ms5611_mbarc_t mbarc;
} __attribute__((packed));

#if CONFIG_USE_GYRO
struct gyro_sample_s {
  int16_t gyro[3];
} __attribute__((packed));
#endif

#if CONFIG_USE_MAG
struct mag_sample_s {
  int16_t mag[3]; /* TODO: Fix naming to make sure it matches mag data */
} __attribute__((packed));
#endif


/**
 * @brief
 */
struct sensor_packet_s {
  uint32_t ticks;

#if CONFIG_USE_TEMP
  uint32_t temp;
#endif // CONFIG_USE_TEMP

  ms5611_mbarc_t mbarc;

#if CONFIG_USE_GPS
  struct gps_sample_s gps_sample;
#endif

#if CONFIG_USE_ACCEL
  struct accel_sample_s accel_sample;
#endif

#if CONFIG_USE_GYRO
  struct gyro_sample_s gyro_sample;
#endif

#if CONFIG_USE_MAG
  struct mag_sample_s mag_sample;
#endif

} __attribute__((packed));

#endif // __SAMPLE_H
