yan/alti/(commit log)

2015-03-22 Starting bringing over i2c/ble/etc functionality
2015-03-22 Blink LED when nrf8001 is ready
2015-03-23 Added kicad project + BMI055 footprint
2015-03-24 Correctly exchanging messages, but main_queue isn't receiving correctly
    [aero.c, globals.h, task_ble.c, task_main.c]
2015-03-25 Moved BLE initialization to BLE task, but still failing on setup
    [task_ble.c, task_main.c]
2015-03-27 Fix cmd sending bug
    [task_ble.c]
2015-03-28 i2c address reorg
2015-03-30 We can now stream pressure via BLE
2015-03-30 Added BMX055 footprint
2015-03-31 Added SON-10 footprint for TI lipoly charger ic
2015-03-31 Add a package outline for (W)SON-10 footprint
2015-03-31 Added stm32l151 (UFQFPN48) footprint
2015-03-31 Added STM32L151C8 component to lib
2015-03-31 Refactor i2c init
2015-03-31 Added UDFN-8 footprint for AT45DB321E
2015-04-01 Added more stm32l1 docs
2015-04-01 Added nrf8001 sheet
    [aero.sch, nrf8001.sch]
2015-04-01 Added xtal footprints
2015-04-03 version 1 of layout
    [aero.kicad_pcb, aero.sch, nrf8001.sch]
2015-04-06 pcb updates
    [aero.kicad_pcb, aero.sch, nrf8001.sch, sensors.sch]
2015-04-10 Added stm32l1 pins spreadsheet
    [stm32l1_pins.xlsx]
2015-04-10 PCB updates, new docs, file reorg
    [aero.sch, bmx055.sch, ms5611.sch, nrf8001.sch, stm32l1_pins.xlsx]
2015-04-10 Removed nRF8001 connections; beginning eventual design
    [aero.kicad_pcb, aero.sch, ms5611.sch, nrf8001.sch]
2015-04-14 Updated pin assignments in spreadsheet
    [stm32l1_pins.xlsx]
2015-04-15 Added mcu, connected nrf8001 and flash, new footprint, other changes
    [aero.sch, at45db321e.sch, bmx055.sch, ms5611.sch, nrf8001.sch, stm32l1_pins.xlsx]
2015-04-15 more progress on hw
    [aero.sch, at45db321e.sch, bmx055.sch, ms5611.sch, nrf8001.sch, power.sch]
2015-04-16 More work on power section
    [aero.sch, power.sch]
2015-04-16 added sensor connections
    [aero.sch, power.sch]
2015-04-16 spreadsheet+schem updates
    [aero.sch, stm32l1_pins.xlsx]
2015-04-22 Lots of hw changes (warn circuits, footprint, etc)
    [aero.sch, at45db321e.sch, bmx055.sch, ms5611.sch, nrf8001.sch, power.sch, stm32l1_pins.xlsx, warn.sch]
2015-04-23 schematic updates
    [aero.sch, power.sch, warn.sch]
2015-04-24 Added some testpoints
    [aero.sch]
2015-04-27 schematic nearing completion
    [aero.sch, warn.sch]
2015-04-28 Deleted nrf8001 breakout
    [aero.kicad_pcb]
2015-04-28 Added component values
    [at45db321e.sch, ms5611.sch, power.sch, warn.sch]
2015-04-28 more changes
    [aero.sch, at45db321e.sch, bmx055.sch, ms5611.sch, nrf8001.sch, power.sch, warn.sch]
2015-05-07 mega commit
    [aero.kicad_pcb, aero.sch, at45db321e.sch, bmx055.sch, ms5611.sch, nrf8001.sch, power.sch, warn.sch]
2015-05-08 Finished layout
    [aero.kicad_pcb, aero.sch, at45db321e.sch, bmx055.sch, ms5611.sch, nrf8001.sch, power.sch, warn.sch]
2015-06-20 ms5611 and nrf8001 in SPI mode both work on the new dev board
2015-06-21 Fix endianness of SPI link
    [globals.h, ms5611.c, spi.c]
2015-06-21 fixed a few known pcb issues
    [aero.kicad_pcb]
2015-06-22 Cleaned up SPI usage
2015-06-22 hw fixes
    [aero.kicad_pcb, warn.sch]
2015-07-01 recent changes
    [aero.kicad_pcb]
2015-07-10 rename baro task to sensor task
2015-07-17 spi/arch updates
2015-07-20 committing hardware updates (probably unnecessary)
    [aero.kicad_pcb, warn.sch]
2015-07-21 imported stm32l1 std periph lib & reorg
2015-07-28 pre major restructuring commit
    [GPS.sch, aero.kicad_pcb, aero.sch, at45db321e.sch, bmx055.sch, ms5611.sch, nrf8001.sch, power.sch]
2015-07-30 committing before shit starts breaking (pcbnew)
    [GPS.sch, aero.sch, nrf8001.sch, power.sch]
2015-07-30 more progress on new layout
    [GPS.sch, aero.kicad_pcb, aero.sch, at45db321e.sch, bmx055.sch, ms5611.sch, nrf8001.sch, power.sch]
2015-07-31 more pcb rework
    [aero.kicad_pcb]
2015-08-06 ver2 is nearing completion.
    [GPS.sch, aero.kicad_pcb, aero.sch, power.sch, warn.sch]
2015-08-07 no more vias under pads
    [aero.kicad_pcb]
2015-08-19 pre-antenna reorg commit
    [GPS.sch, aero.kicad_pcb]
2015-08-19 rewired sensors + gps
    [aero.kicad_pcb]
2015-09-16 Updated pin references
2015-09-16 Updated pin gen script
2015-09-17 moved balun further from nrf8001
    [aero.kicad_pcb]
2015-09-30 Intermediate commit
    [aero.kicad_pcb]
2015-10-23 pre-net import
    [GPS.sch, aero.kicad_pcb, aero.sch, power.sch, warn.sch]
2015-10-24 passes DRC with stitching
    [aero.kicad_pcb, warn.sch]
2015-10-24 now with normal vias
    [aero.kicad_pcb]
2015-10-28 remove backup files from git
    [aero.kicad_pcb]
2015-10-29 remove i2c from repo
2015-11-09 update spi api
2015-11-15 intermediate commit, every sensor works (!!)
2015-11-17 more sensor work
2015-11-17 makefile update && start of sensor packet def
2015-11-18 committing yesterdays code; uart handler+co
2015-11-19 intermediate commit - uart works with isrs and switching baud rates works
2015-12-02 start on sample header
2016-01-11 ble+gps works with stm32periph!
2016-01-13 [wip] pushing while working out linking issues
    [flash.c, flash.h, globals.c, globals.h, logger.c, logger.h]
2016-01-25 some reorg + bufio fixes + tests
    [buffered_io.c, buffered_io.h, logger.c, logger.h, logger_private.h]
2016-08-03 Various changes (see commit msg)
    * Fix mutex protection for SPI bus
    * Fix BLE (!!)
    * Add a counter
    * Add a pin_get() function
    * Rework config message handling
    * Update nRF8001 handling
    * Cripple ublox handling code temporarily (do not wait for responses)
    [aero.c, config.c, counters.h, features.h, flash.c, globals.h, hal.h, hal_stm32_libopencm3.c]
2016-08-12 Update spi bus locking
2016-08-12 Start/stop gps again [still broken; ref commit]
    [task_main.c]
2016-08-26 Testing, SPI locking, BLE updates
